h4/curtains-driver/other/blind_mount.FCStd

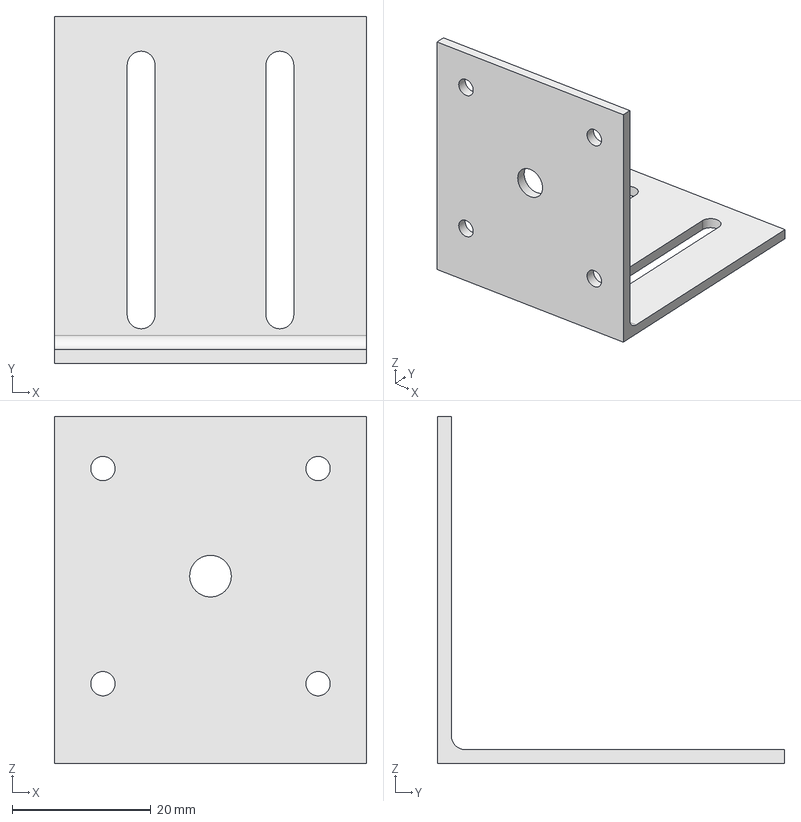
[picture p1: CAD file, 2020-01-12]
other/blind_mount.FCStd
45.0 x 50.0 x 50.0 mm
