h4/curtains-driver/other/cap.FCStd

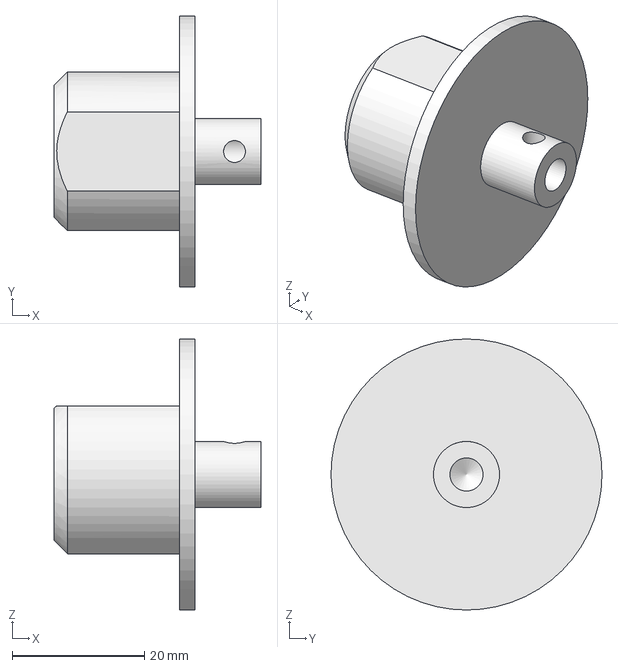
[picture p2: CAD file, 2019-11-10]
other/cap.FCStd
31.3 x 41.0 x 41.0 mm
