h4/curtains-driver/other/cap.pdf

B

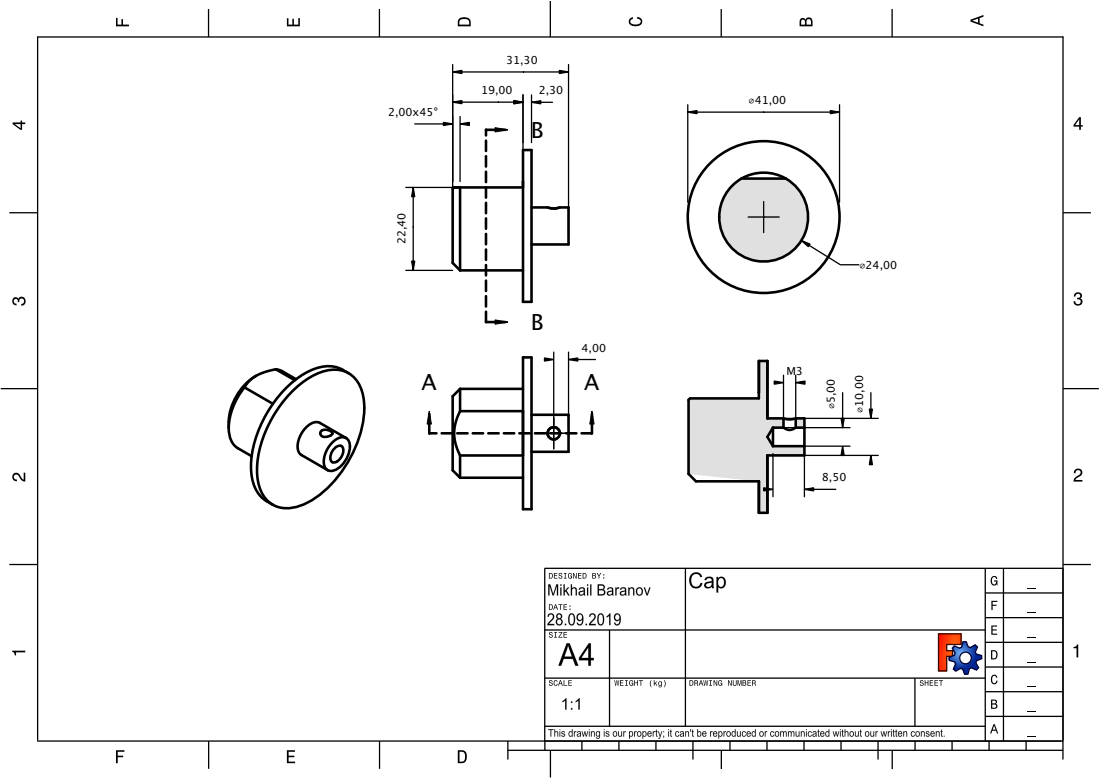
[picture p3: page 1]
