h4/curtains-driver/pcb/curtains-driver.kicad_pcb

## KiCad design pcb/curtains-driver.kicad_pcb (2019-11-10)

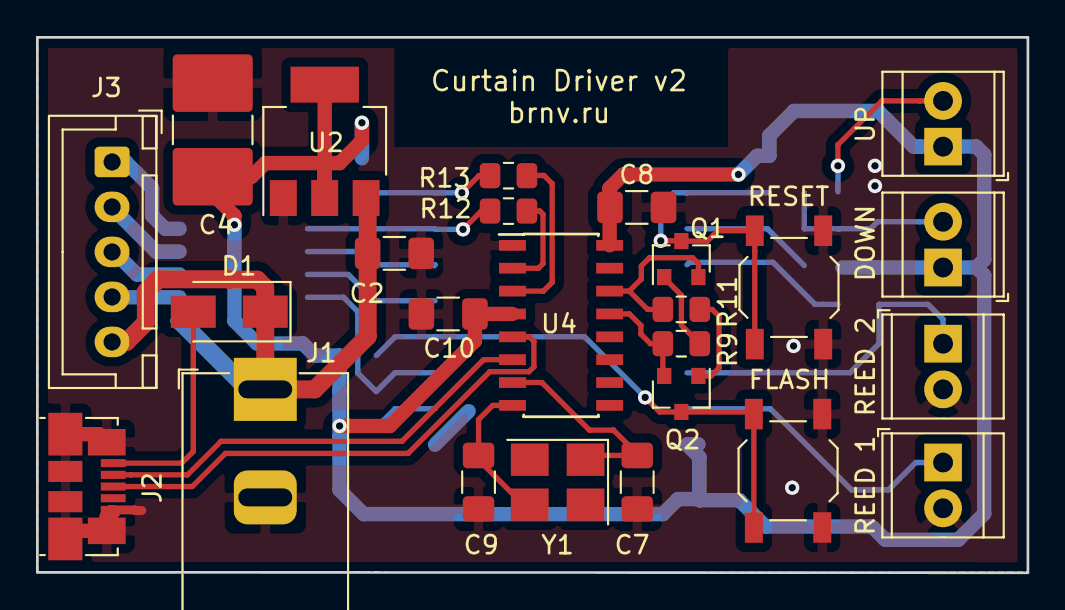
[picture p4: board curtains-driver.kicad_pcb from above]

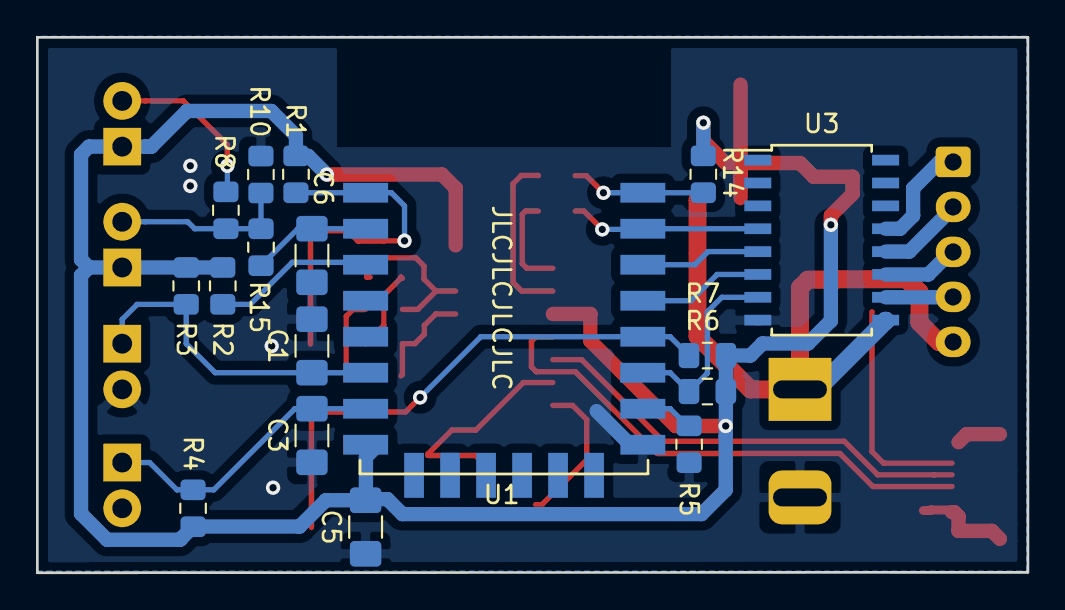
[picture p5: board curtains-driver.kicad_pcb from below]

Board: 2 copper layers, 55.0 x 29.7 mm, 42 parts (17 on the bottom side), 32 nets.

Parts:
C1, C3, C5: 0.1uF; C_1206_3216Metric_Pad1.42x1.75mm_HandSolder
C2, C8, C10: 10uF; C_1206_3216Metric_Pad1.42x1.75mm_HandSolder
C4: 100uF; C_2816_7142Metric_Pad3.20x4.45mm_HandSolder
C6: 10nF; C_1206_3216Metric_Pad1.42x1.75mm_HandSolder
C7, C9: 22pF; C_1206_3216Metric_Pad1.42x1.75mm_HandSolder
D1: M7; D_SMA
FLASH: FLASH; SW_SPST_TL3342
J1: Barrel_Jack; BarrelJack_Horizontal_DS_201
J2: USB_B_Micro; USB_Micro-B_Molex_47346-0001
J3: Motor; JST_XH_B05B-XH-A_1x05_P2.50mm_Vertical
J6, J7: Reed_1; TerminalBlock_TE_282834-2_1x02_P2.54mm_Horizontal
Q1, Q2: S8050; SOT-23
R1, R2, R3, R4, R5, R6, R7, R8, R9, R11, R14: 10K; R_0805_2012Metric_Pad1.15x1.40mm_HandSolder
R10: 2K2; R_0805_2012Metric_Pad1.15x1.40mm_HandSolder
R12, R13: 470; R_0805_2012Metric_Pad1.15x1.40mm_HandSolder
R15: 1K; R_0805_2012Metric_Pad1.15x1.40mm_HandSolder
RESET: RESET; SW_SPST_TL3342
SW3: UP; TerminalBlock_TE_282834-2_1x02_P2.54mm_Horizontal
SW4: DOWN; TerminalBlock_TE_282834-2_1x02_P2.54mm_Horizontal
U1: ESP-12F; ESP-12E_SMD
U2: LM1117-3.3; SOT-223-3_TabPin2
U3: ULN2003A; SOIC-16W_5.3x10.2mm_P1.27mm
U4: CH340G; SOIC-16_3.9x9.9mm_P1.27mm
Y1: HC-49; Crystal_SMD_SeikoEpson_FA238V-4Pin_3.2x2.5mm_HandSoldering

Connections:
+5V: C2.1, D1.1, J1.1, J3.5, U2.3, U3.9
/D+: J2.3, U4.5
/D-: J2.2, U4.6
ADC: C6.1, R15.2, U1.2
Earth: C1.2, C2.2, C3.2, C4.2, C5.2, C6.2, C7.2, C8.2, C9.2, C10.2, FLASH.2, J1.2, J2.5, J2.6, J6.2, J7.2, R5.1, R10.1, RESET.1, U1.9, U2.1, U3.8, U4.1
GPIO0: FLASH.1, Q2.3, R7.2, U1.12
unnamed: C1.1, J6.1, R3.1, U1.6
unnamed: C3.1, J7.1, R4.1, U1.7
unnamed: C7.1, U4.7, Y1.1
unnamed: C9.1, U4.8, Y1.3
unnamed: D1.2, J2.1
unnamed: J3.1, U3.13
unnamed: J3.2, U3.12
unnamed: J3.3, U3.11
unnamed: J3.4, U3.10
unnamed: Q1.1, R9.1
unnamed: Q1.2, R11.2, U4.14
unnamed: Q2.1, R11.1
unnamed: Q2.2, R9.2, U4.13
unnamed: R2.1, U1.3
unnamed: R5.2, U1.10
unnamed: R6.2, U1.11, U3.7
unnamed: R8.2, SW4.2
unnamed: R8.1, R10.2, R15.1, SW3.2
unnamed: R12.2, U4.2
unnamed: R13.2, U4.3
unnamed: U1.13, U3.6
unnamed: U1.14, U3.5
RST: Q1.3, R1.1, RESET.2, U1.1
RXD: R12.1, U1.15, U3.4
TXD: R13.1, R14.1, U1.16
VCC: C4.1, C5.1, C8.1, C10.1, R1.2, R2.2, R3.2, R4.2, R6.1, R7.1, R14.2, SW3.1, SW4.1, U1.8, U2.2, U4.4, U4.16
