h4/curtains-driver/(commit log)

2018-12-23 Refactor Circuit
    [curtains-driver.kicad_pcb, curtains-driver.sch]
2019-01-02 Add USB-UART chip
    [curtains-driver.kicad_pcb, curtains-driver.sch, esp-8266-12.sch]
2019-01-08 Code sample
2019-01-13 Switch to AccellStepper library
2019-04-07 Update PCB
    [curtains-driver-B_Cu.gbr, curtains-driver-B_Mask.gbr, curtains-driver-B_Paste.gbr, curtains-driver-B_SilkS.gbr, curtains-driver-Edge_Cuts.gbr, curtains-driver-F_Cu.gbr, curtains-driver-F_Mask.gbr, curtains-driver-F_Paste.gbr]
2019-05-22 Fix stepper initialization
2019-06-11 Minimal working result
    [curtains-driver.csv, curtains-driver.kicad_pcb, curtains-driver.sch]
2019-07-03 Simplify buttons processing
2019-07-08 Change PWM and UART circuit
    [curtains-driver.kicad_pcb, curtains-driver.sch]
2019-07-10 Change ADC resistor divider nominals
    [curtains-driver.sch]
2019-07-10 Read UP/DOWN buttons correctly
    [main.cpp]
2019-07-10 Make terminals labels visible after wirig
    [curtains-driver.kicad_pcb]
2019-07-14 Read buttons values in timer intrerupt callback
2019-07-28 Process long pressed button
2019-09-29 Add Cap drawing
    [cap.FCStd]
2019-10-01 Run motor continiusly
2020-01-12 Add new Blind Mount
    [cover_mount.FCStd]
2020-01-12 Rename mount files
    [blind_mount.FCStd]
